rsispal/ILSS-DisabilityIN-Demo-2026/firmware/docs/STATE_MACHINE.md

# Link & indication state machine

How the lanyard and web twin move between link states, what the LEDs / actuators show, and which events drive each transition.

## Overview

```mermaid
stateDiagram-v2
  [*] --> Boot

  Boot --> Unpaired: power-up cue done
  note right of Boot
    LED: white + red star twinkle (~1.8s)
    Haptic: soft bumps (DRV #7)
    Buzzer: ascending beep-beep-BEEP (2–3.5 kHz)
    CLI wait: 2s (blue single flash)
  end note

  Unpaired --> Connecting: GATT connect
  note right of Unpaired
    LED: blue single flash / 3s @ 20%
    Ready / advertising
  end note

  Connecting --> PairedIdle: pair_ok
  Connecting --> Unpaired: disconnect / fail
  note right of Connecting
    LED: blue chase @ 30%
    Pairing in progress
  end note

  PairedIdle --> AlertFire: fire twin / web fire
  PairedIdle --> AlertPersonal: both-hold / personal twin
  PairedIdle --> Advanced: advanced twin (idle only)
  PairedIdle --> Unpaired: disconnect / HB fail
  note right of PairedIdle
    LED: green solid @ 10%
    After pair: brief green flash @ 100%
    Heartbeat every 10s
  end note

  AlertFire --> PairedIdle: clear / stand-down
  AlertFire --> Unpaired: disconnect / HB fail
  note right of AlertFire
    LED: red double-flash @ 100%
    Haptic: long-pulses (Alert 1000ms)
    Buzzer: code3-sweep
  end note

  AlertPersonal --> PairedIdle: clear / both-hold toggle
  AlertPersonal --> Unpaired: disconnect / HB fail
  note right of AlertPersonal
    LED: purple pulse @ 100%
    Haptic: long-pulses
    Buzzer: code3-siren
  end note

  Advanced --> PairedIdle: reset / idle twin
  Advanced --> Unpaired: disconnect / HB fail
  note right of Advanced
    LED/haptic/buzzer: commanded
    Web 30s autoreset
  end note
```

## Link states (device)

| State | How entered | LED indication | Other actuators | Exit events |
|---|---|---|---|---|
| **Boot** | Power-on / reset | White + red star twinkle (~1.8s); CLI wait blue single flash @ 20% | Soft haptic bumps + ascending beep-beep-BEEP (2–3.5 kHz) | Cue done → Unpaired |
| **Unpaired** | Boot done, disconnect, heartbeat fail | Blue `FLASH_SINGLE_3S` @ 20% | Off (stand-down clears alerts) | GATT connect → Connecting |
| **Connecting** | BLE GAP connect (not yet paired) | Blue chase @ 30% | Off | `pair_ok` → PairedIdle; disconnect → Unpaired |
| **PairedIdle** | Successful pair / alert clear | Green solid @ 10% (pair flash @ 100% first) | Off | Twin CMD, both-hold, disconnect, HB fail |
| **AlertFire** | Twin fire / web fire | Red double-flash @ 100% | Long-pulses haptic, code3-sweep buzzer | Clear → PairedIdle; disconnect/HB fail → Unpaired |
| **AlertPersonal** | Both-hold / twin personal | Purple pulse @ 100% | Long-pulses haptic, code3-siren | Clear / both-hold toggle → PairedIdle; disconnect/HB fail → Unpaired |
| **Advanced** | Twin with advanced flag while idle | Commanded LED pattern/color/brightness | Commanded haptic/buzzer | Idle twin / autoreset; disconnect/HB fail → Unpaired |

Stand-down on disconnect / heartbeat failure always: stop buzzer + haptics, clear alert to idle twin, set **Unpaired** blue flash, republish status.

## Heartbeat / poll

```mermaid
sequenceDiagram
  participant D as Lanyard
  participant W as Web twin

  Note over D,W: Paired session
  loop every 10s
    D->>W: EVT/CMD HEARTBEAT (0x02) + TwinState
    W->>W: Green LED pulse (UI only)
    W->>D: ACK HEARTBEAT (same msgId)
    alt no ACK within 4s
      D->>D: disconnect + Unpaired
      W->>W: link-lost modal (if silent)
    end
  end

  Note over W: If no device poll for ~12s
  W->>D: CMD HEARTBEAT
  alt RPL/ACK within 4s
    W->>W: Green LED pulse
  else timeout / write fail
    W->>W: Disconnect + "reset device" modal
  end
```

| Side | Interval | Timeout | On failure |
|---|---|---|---|
| **Device** | Poll every **10s** after pair | **4s** waiting for ACK | `ble_gap_terminate` → Unpaired (blue flash), clear indications |
| **Web** | Expect device poll; fallback poll after **~12s** silence | **4s** for reply | Disconnect GATT, show link-lost modal (“reset the lanyard”) |
| **Web UI** | On any successful heartbeat (device poll or web-poll reply) | — | Brief green LED pulse on virtual lanyard (no device LED change) |

## Other events

| Event | Source | Effect |
|---|---|---|
| Side button short press (L/R) | Device | EVT `0x10` button cue → web purple side-button flash (~280ms) |
| Both buttons hold | Device | Raise / clear personal alert + twin EVT |
| Twin state CMD | Web | Apply if mutual-exclusion / alert rules allow; ACK or NAK |
| Twin state EVT | Device | Web mirrors state (skip outbound echo) |
| Unpair (`0x03`) | Web | Clear session; device unpaired |

## Indication cheat-sheet

| Cue | Color | Pattern | When |
|-----|---|---|---|
| Ready | Blue | Single flash / 3s @ 20% | Unpaired / CLI wait |
| Pairing | Blue | Chase @ 30% | GATT connected, awaiting pair |
| Pair success | Green | Solid flash ~450ms @ 100% | `pair_ok` |
| Idle linked | Green | Solid @ 10% | Paired, no alert |
| Fire | Red | Double flash @ 100% | Fire alert |
| Personal | Purple | Pulse @ 100% | Personal alert |
| Web heartbeat | Green | Brief brightness pulse | UI only, on poll RX |

See also: [PACKET_PROTOCOL.md](PACKET_PROTOCOL.md), [PAIRING.md](PAIRING.md), [BLE_GATT.md](BLE_GATT.md).
