rsispal/ILSS-DisabilityIN-Demo-2026/frontend/uploads/honeywell-emboss.png

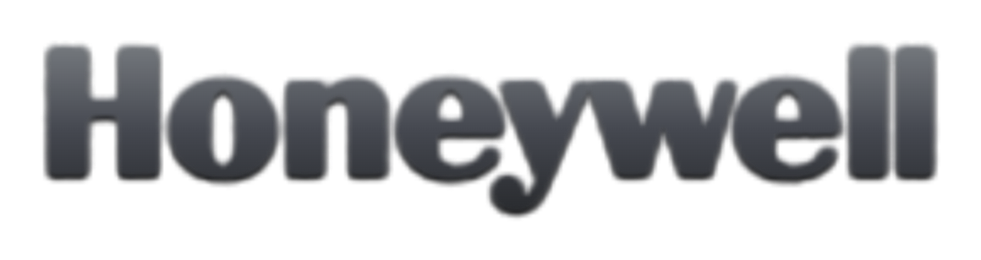
frontend/uploads/honeywell-emboss.png
