rsispal/ILSS-DisabilityIN-Demo-2026/pcb/ILSS_PCB_2026_DEMO/ILSS_LIBRARY/3D/UJ20-C-H-G-SMT-1-P16-TR.step

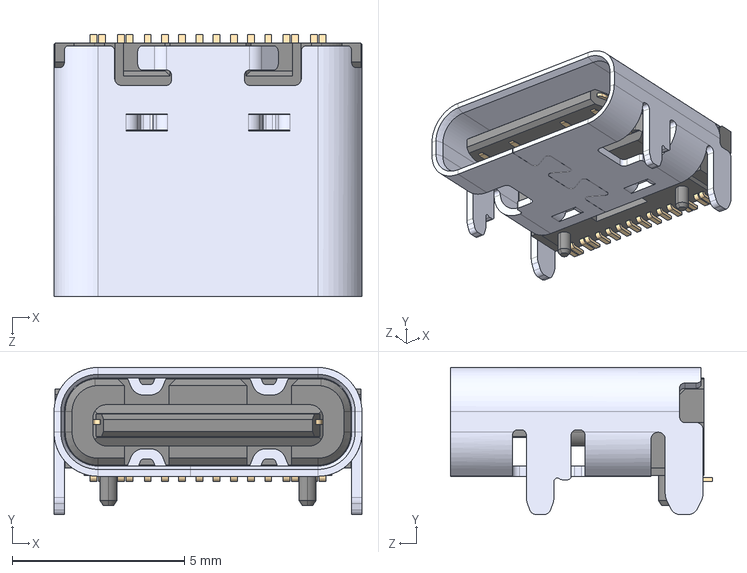
[picture p2: CAD file, 2026-07-12]
pcb/ILSS_PCB_2026_DEMO/ILSS_LIBRARY/3D/UJ20-C-H-G-SMT-1-P16-TR.step
8.94 x 4.27 x 7.60 mm
