rsispal/ILSS-DisabilityIN-Demo-2026/pcb/ILSS_PCB_2026_DEMO/ILSS_LIBRARY/3D/IN-S63BT.stp

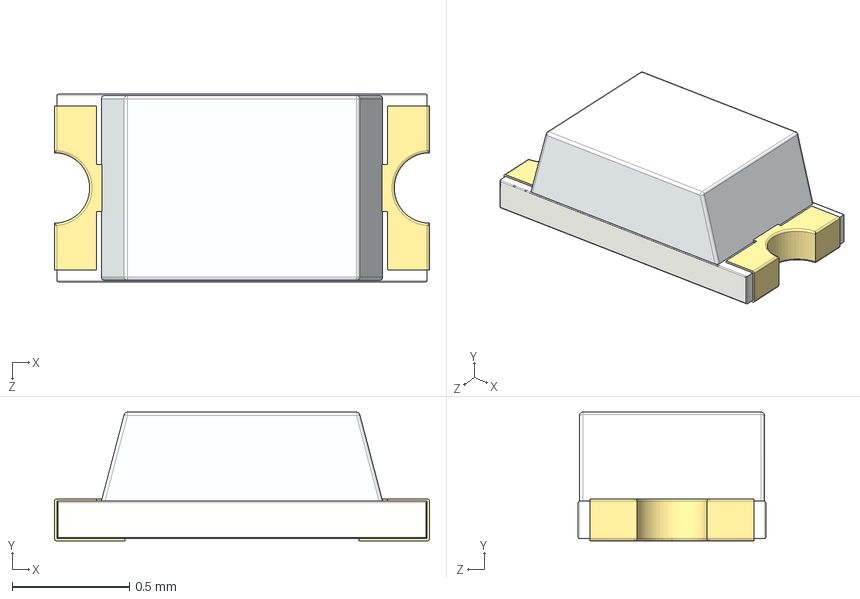
[picture p3: CAD file, 2026-07-12]
pcb/ILSS_PCB_2026_DEMO/ILSS_LIBRARY/3D/IN-S63BT.stp
1.60 x 0.55 x 0.8 mm
