rsispal/ILSS-DisabilityIN-Demo-2026/pcb/ILSS_PCB_2026_DEMO/ILSS_LIBRARY/3D/SLW-864574-5A-RA-N-D.step

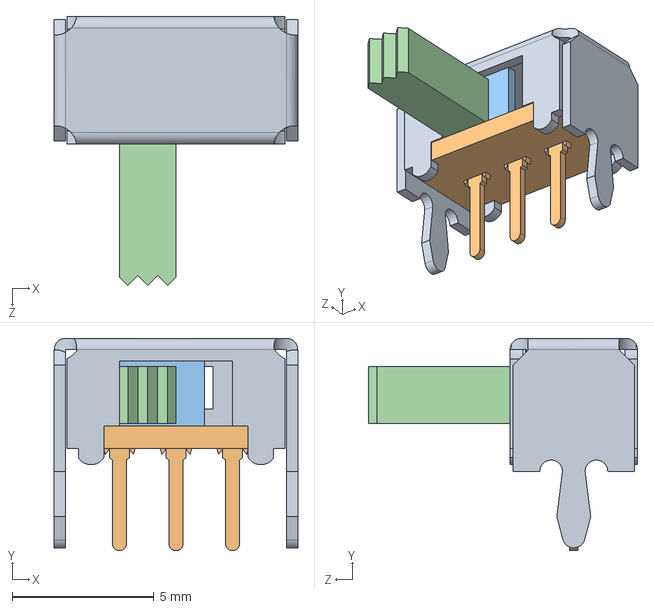
[picture p4: CAD file, 2026-07-12]
pcb/ILSS_PCB_2026_DEMO/ILSS_LIBRARY/3D/SLW-864574-5A-RA-N-D.step
8.60 x 7.50 x 9.50 mm
