rsispal/ILSS-DisabilityIN-Demo-2026/pcb/ILSS_PCB_2026_DEMO/ILSS_LIBRARY/3D/ADAFRUIT_SK6812_SIDE_4691.stp

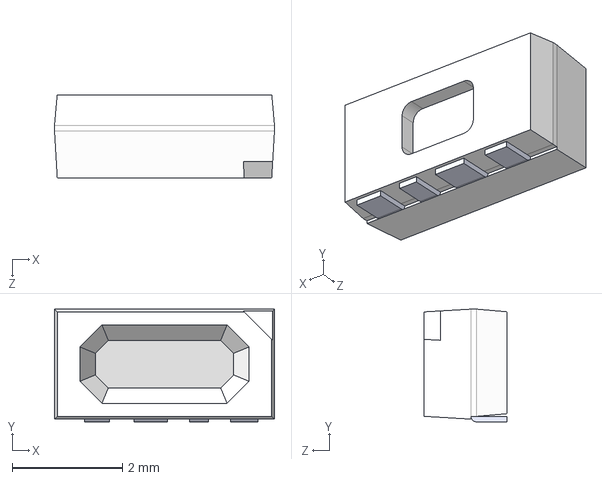
[picture p5: CAD file, 2026-07-12]
pcb/ILSS_PCB_2026_DEMO/ILSS_LIBRARY/3D/ADAFRUIT_SK6812_SIDE_4691.stp
4.00 x 2.05 x 1.50 mm
