rsispal/ILSS-DisabilityIN-Demo-2026/pcb/ILSS_PCB_2026_DEMO/ILSS_LIBRARY/3D/DRV2605LDGSR.stp

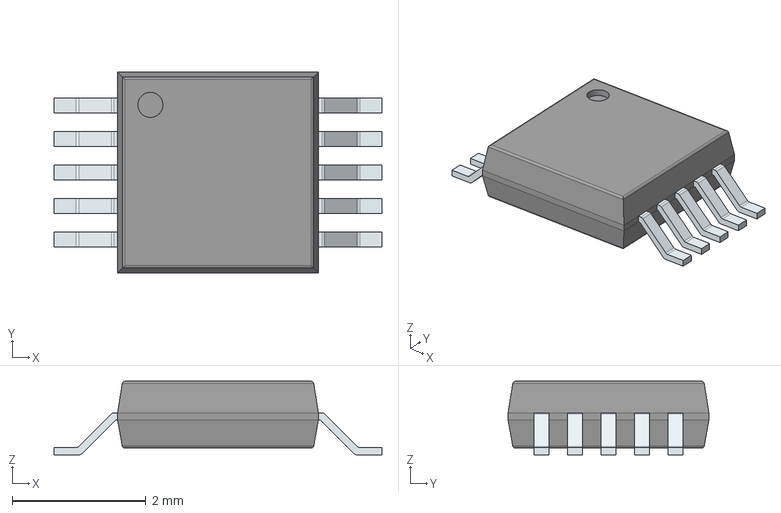
[picture p6: CAD file, 2026-07-12]
pcb/ILSS_PCB_2026_DEMO/ILSS_LIBRARY/3D/DRV2605LDGSR.stp
4.90 x 3.00 x 1.10 mm
PinsArrayLR
