rsispal/ILSS-DisabilityIN-Demo-2026/pcb/ILSS_PCB_2026_DEMO/ILSS_LIBRARY/3D/S2B-PH-SM4-TB.step

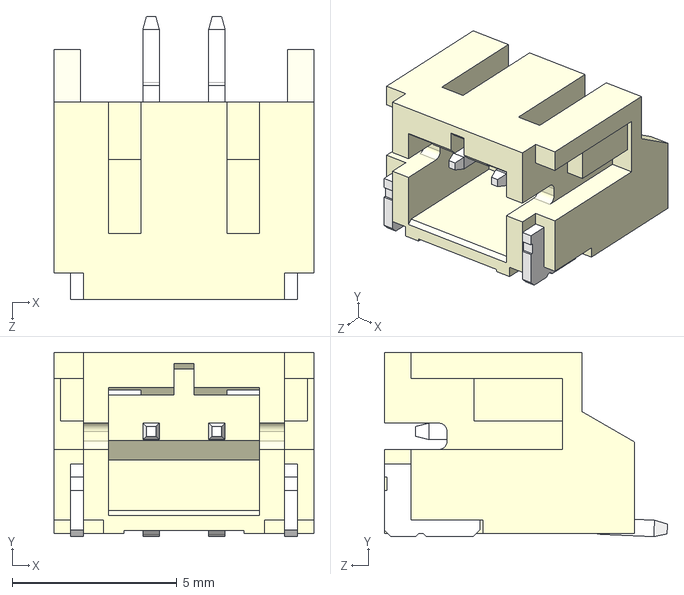
[picture p7: CAD file, 2026-07-12]
pcb/ILSS_PCB_2026_DEMO/ILSS_LIBRARY/3D/S2B-PH-SM4-TB.step
7.90 x 5.60 x 8.60 mm
