rsispal/ILSS-DisabilityIN-Demo-2026/pcb/ILSS_PCB_2026_DEMO/ILSS_LIBRARY/3D/TS11-674-50-BK-160-RA-D.step

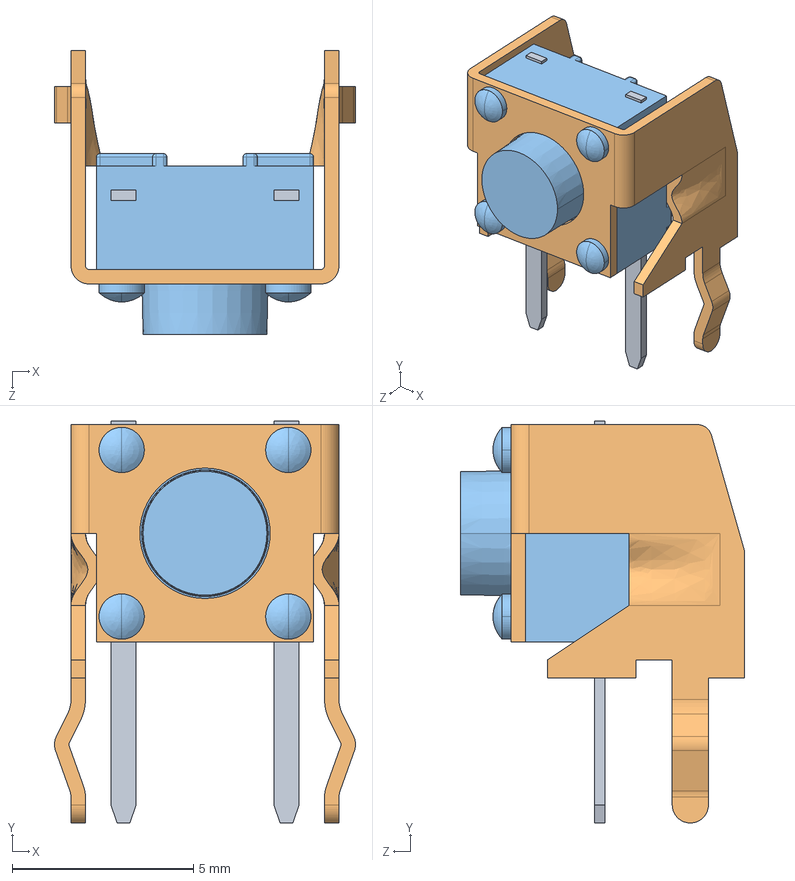
[picture p8: CAD file, 2026-07-12]
pcb/ILSS_PCB_2026_DEMO/ILSS_LIBRARY/3D/TS11-674-50-BK-160-RA-D.step
8.31 x 11.1 x 7.85 mm
