rsispal/ILSS-DisabilityIN-Demo-2026/pcb/ILSS_PCB_2026_DEMO/ILSS_LIBRARY/3D/CMT-7525-03-SMT-TR.stp

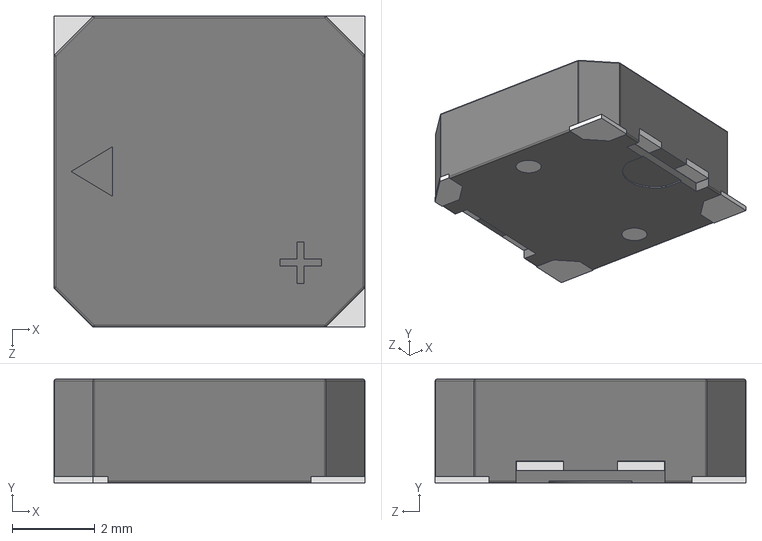
[picture p9: CAD file, 2026-07-12]
pcb/ILSS_PCB_2026_DEMO/ILSS_LIBRARY/3D/CMT-7525-03-SMT-TR.stp
7.50 x 2.50 x 7.50 mm
