rsispal/ILSS-DisabilityIN-Demo-2026/pcb/ILSS_PCB_2026_DEMO/ILSS_LIBRARY/3D/MAX17048G_T10.step

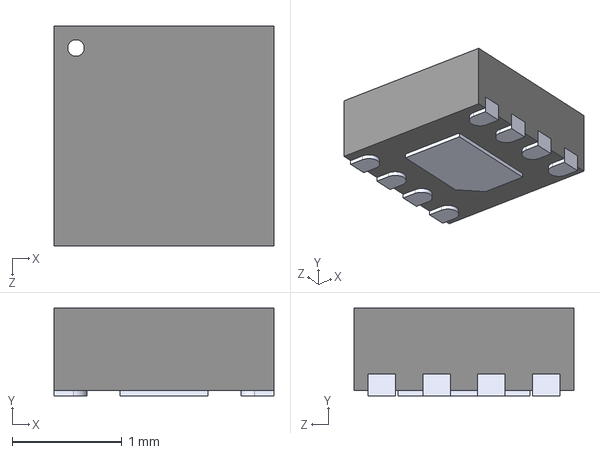
[picture p10: CAD file, 2026-07-12]
pcb/ILSS_PCB_2026_DEMO/ILSS_LIBRARY/3D/MAX17048G_T10.step
2.00 x 0.8 x 2.00 mm
