rsispal/ILSS-DisabilityIN-Demo-2026/pcb/ILSS_PCB_2026_DEMO/ILSS_PCB_2026_DEMO.kicad_pcb

## KiCad design pcb/ILSS_PCB_2026_DEMO/ILSS_PCB_2026_DEMO.kicad_pcb (2026-07-13)

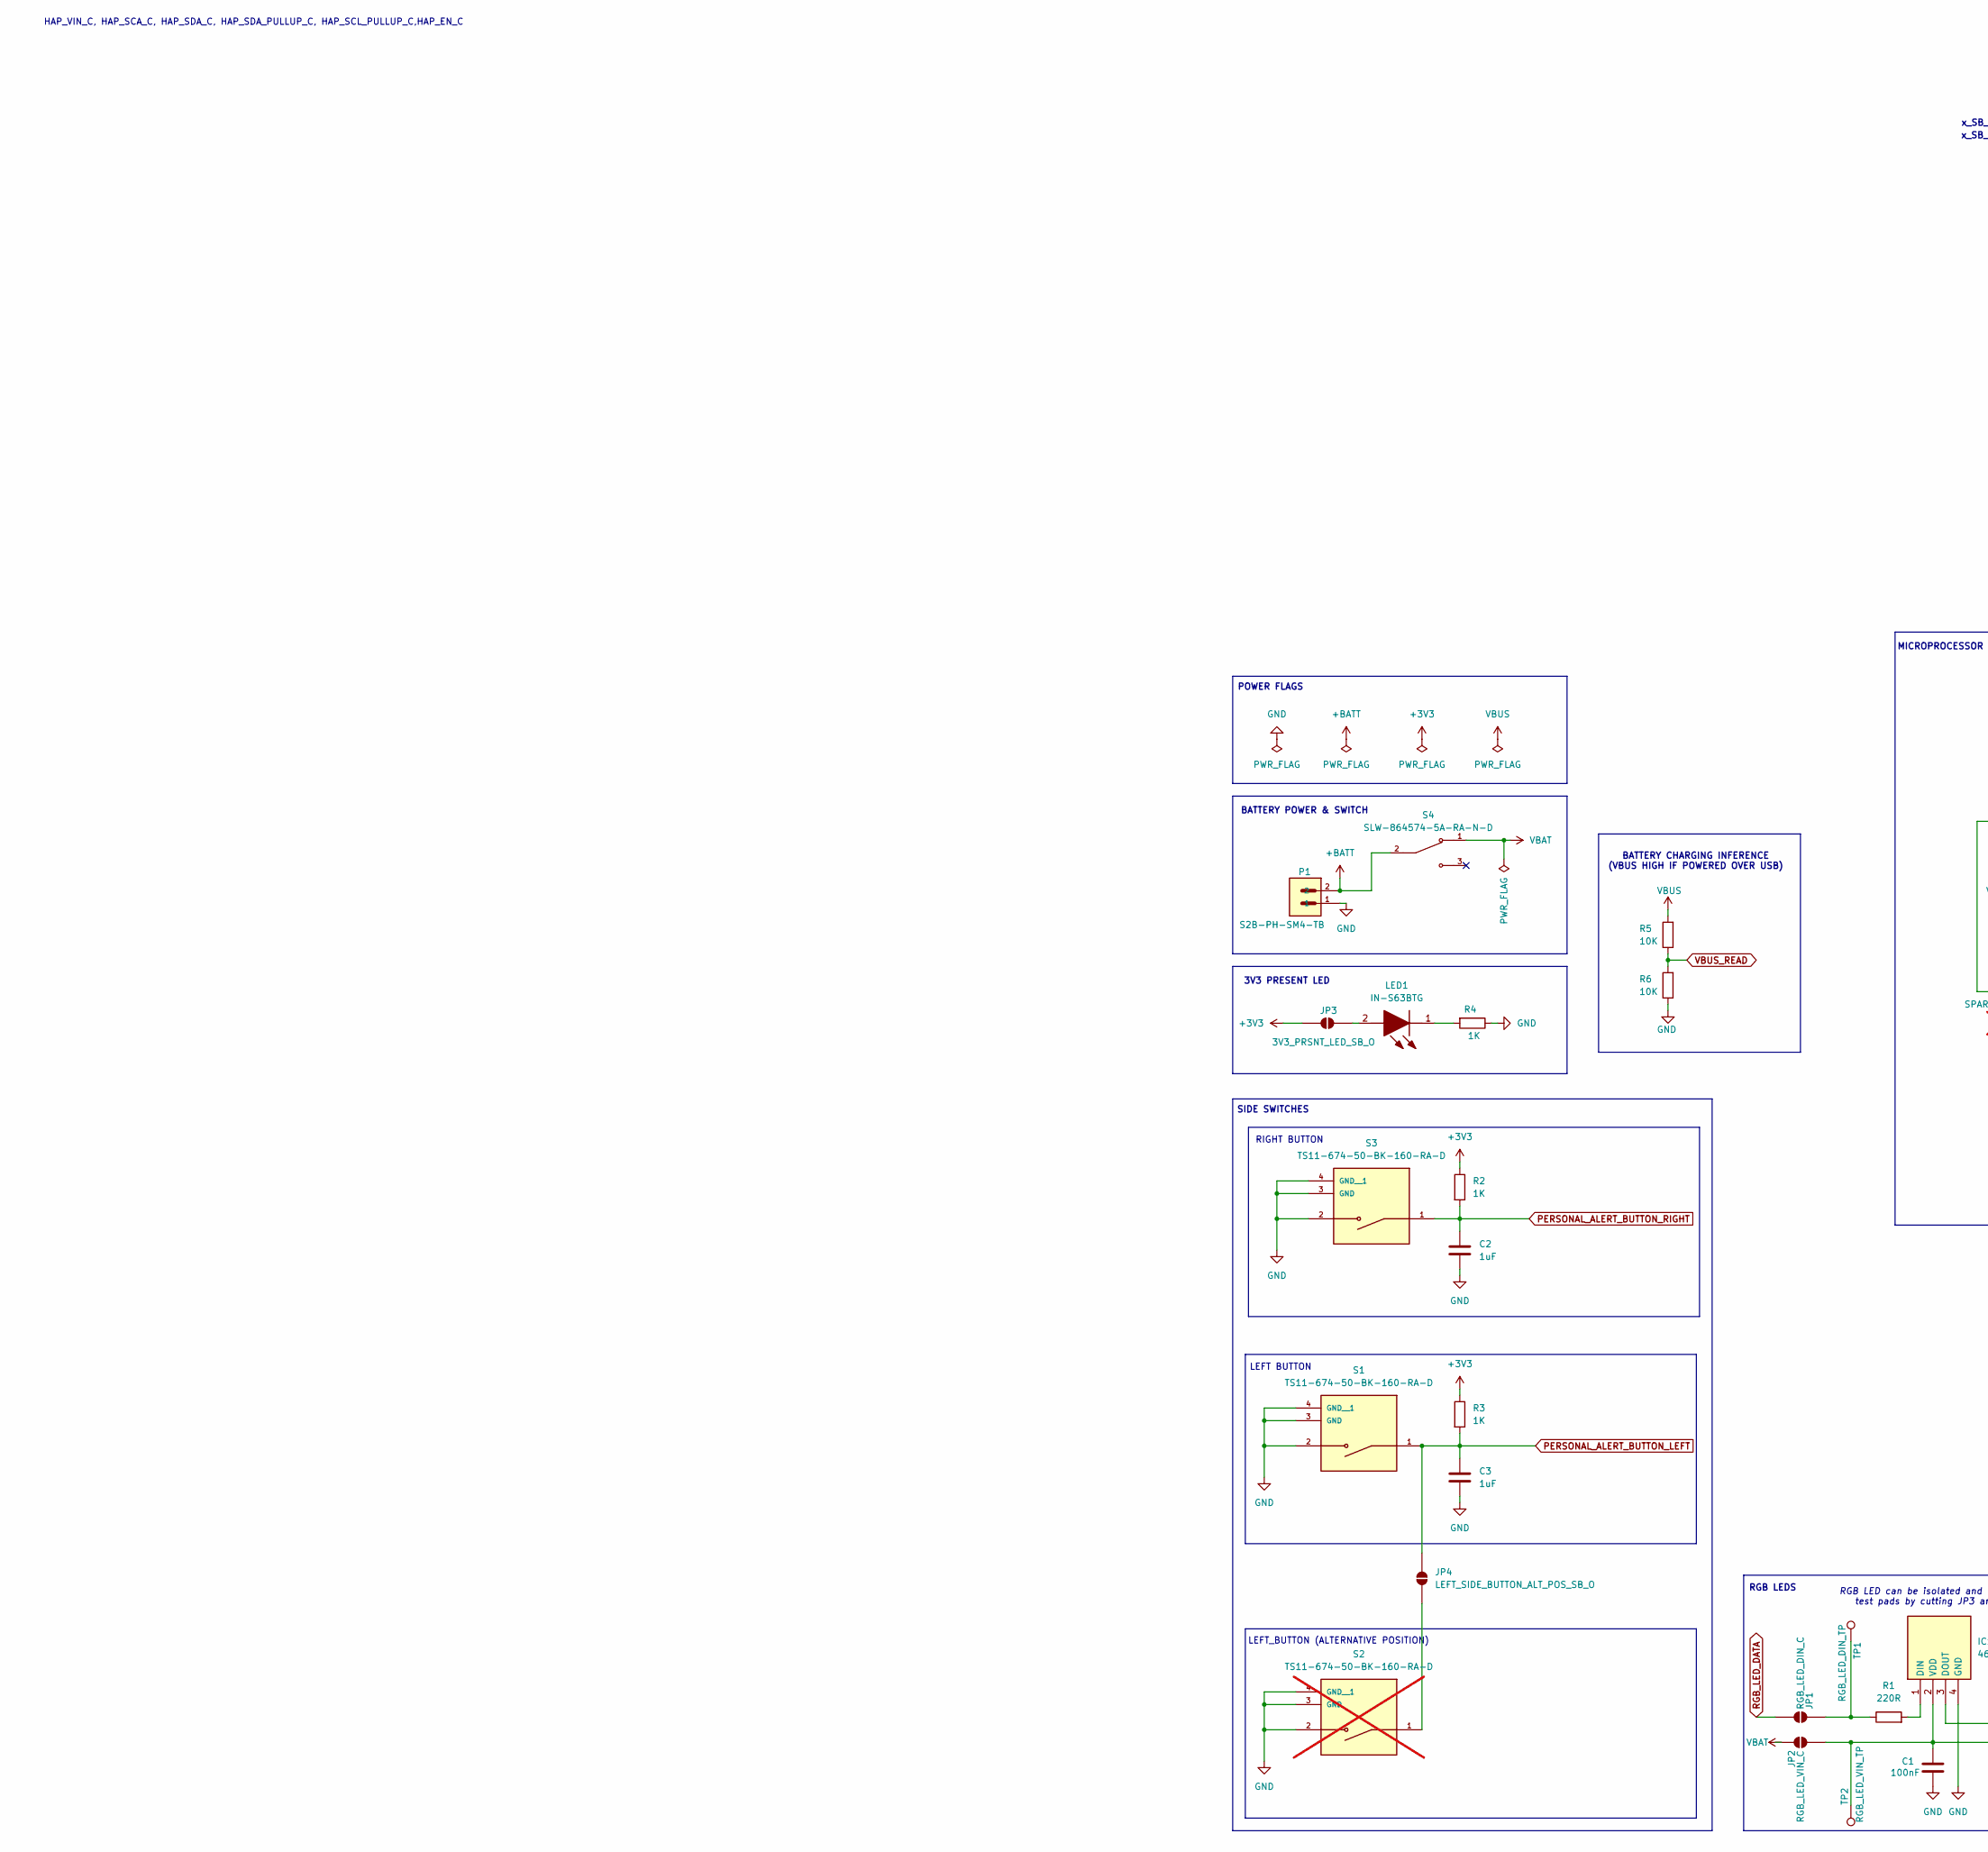
[picture p11: schematic ILSS_PCB_2026_DEMO.kicad_sch, ILSS LANYARD PROTOTYPE (DISABILITY:IN 2026), part in row 1, column 1]

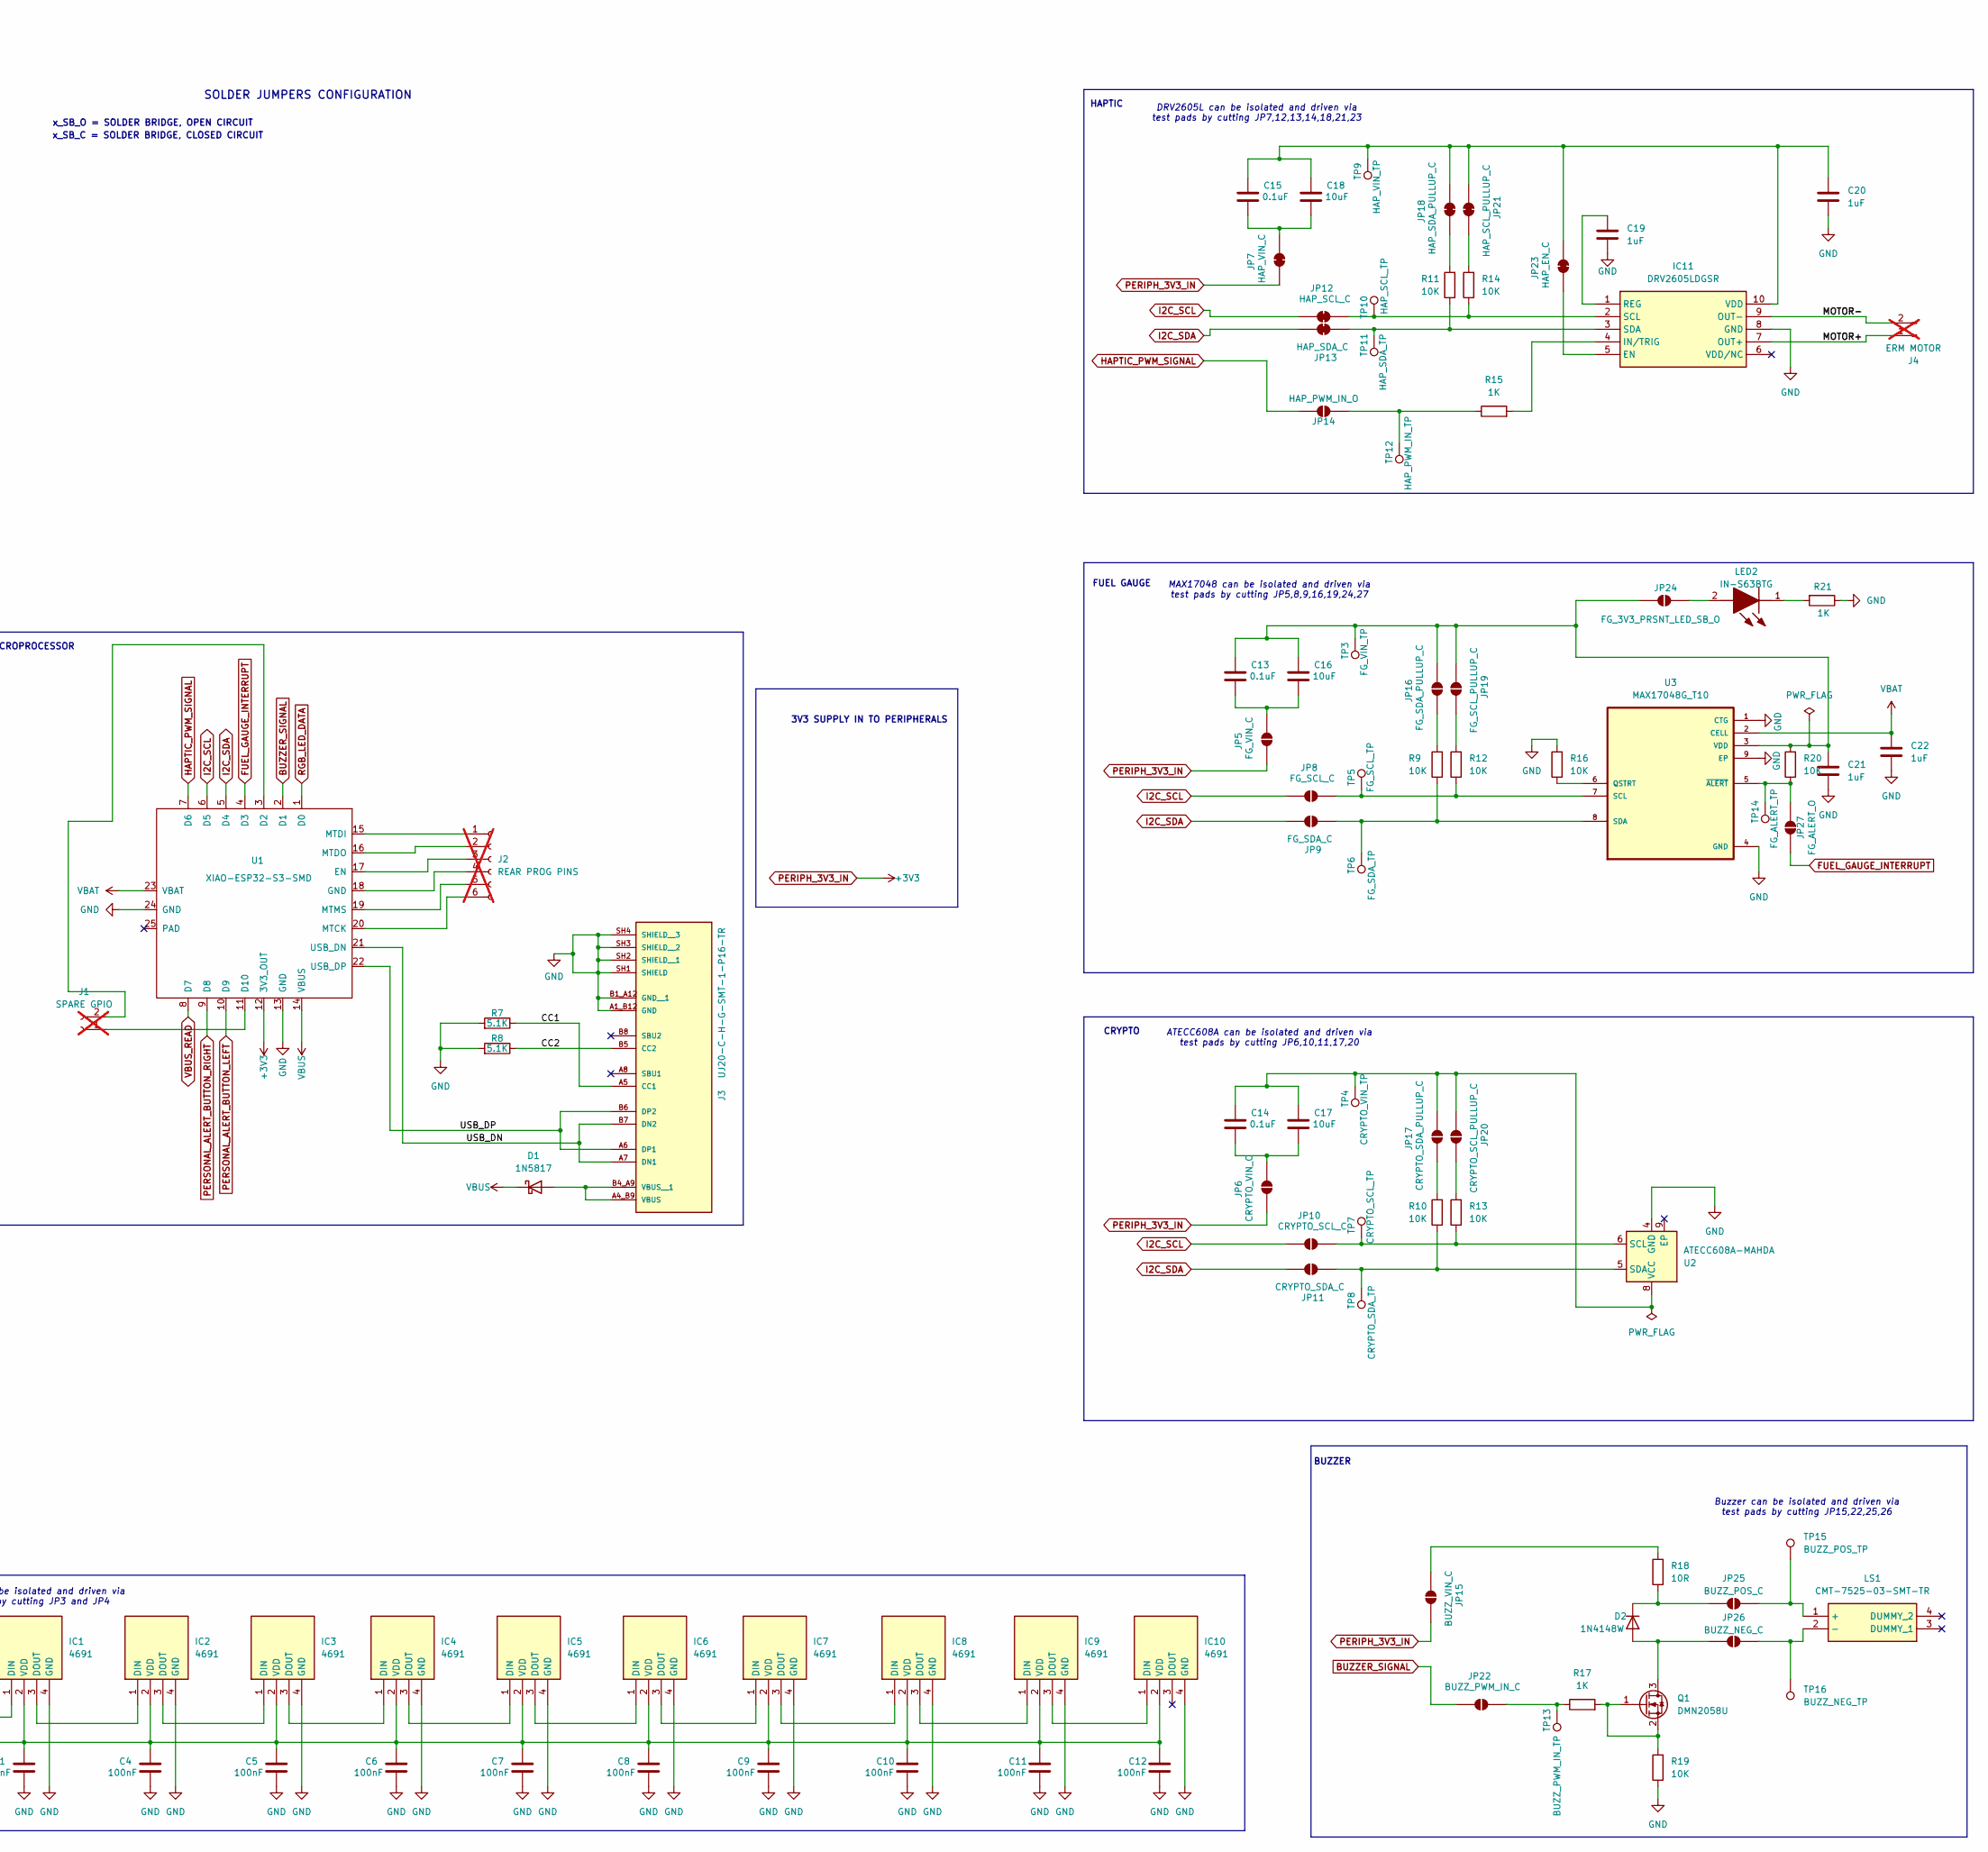
[picture p12: schematic ILSS_PCB_2026_DEMO.kicad_sch, ILSS LANYARD PROTOTYPE (DISABILITY:IN 2026), part in row 1, column 2]

Parts:
C1, C4, C5, C6, C7, C8, C9, C10, C11, C12: 100nF; C_0603_1608Metric_Pad1.08x0.95mm_HandSolder
C2, C3, C19, C20, C21, C22: 1uF; C_0603_1608Metric_Pad1.08x0.95mm_HandSolder
C13, C14, C15: 0.1uF; C_0603_1608Metric_Pad1.08x0.95mm_HandSolder
C16, C17, C18: 10uF; C_0603_1608Metric_Pad1.08x0.95mm_HandSolder
D1: 1N5817; D_SOD-123
D2: 1N4148W; D_SOD-123
IC1, IC2, IC3, IC4, IC5, IC6, IC7, IC8, IC9, IC10: 4691; ADAFRUIT_SK6812_SIDE_4691; Mouser Part Number 485-4691
IC11: DRV2605LDGSR; SOP50P490X110-10N; Mouser Part Number 595-DRV2605LDGSR
J1: SPARE GPIO; PinHeader_1x02_P2.54mm_Vertical; not fitted
J2: REAR PROG PINS; PinHeader_1x06_P2.54mm_Vertical; not fitted
J3: UJ20-C-H-G-SMT-1-P16-TR; SAMESKY_UJ20-C-H-G-SMT-1-P16-TR; PARTREV 1.0
J4: ERM MOTOR; PinHeader_1x02_P2.54mm_Vertical; not fitted
JP1: RGB_LED_DIN_C; SolderJumper-2_P1.3mm_Open_Pad1.0x1.5mm
JP2: RGB_LED_VIN_C; SolderJumper-2_P1.3mm_Open_Pad1.0x1.5mm
JP3: 3V3_PRSNT_LED_SB_O; SolderJumper-2_P1.3mm_Open_Pad1.0x1.5mm
JP4: LEFT_SIDE_BUTTON_ALT_POS_SB_O; SolderJumper-2_P1.3mm_Open_Pad1.0x1.5mm
JP5: FG_VIN_C; SolderJumper-2_P1.3mm_Open_Pad1.0x1.5mm
JP6: CRYPTO_VIN_C; SolderJumper-2_P1.3mm_Open_Pad1.0x1.5mm
JP7: HAP_VIN_C; SolderJumper-2_P1.3mm_Open_Pad1.0x1.5mm
JP8: FG_SCL_C; SolderJumper-2_P1.3mm_Open_Pad1.0x1.5mm
JP9: FG_SDA_C; SolderJumper-2_P1.3mm_Open_Pad1.0x1.5mm
JP10: CRYPTO_SCL_C; SolderJumper-2_P1.3mm_Open_Pad1.0x1.5mm
JP11: CRYPTO_SDA_C; SolderJumper-2_P1.3mm_Open_Pad1.0x1.5mm
JP12: HAP_SCL_C; SolderJumper-2_P1.3mm_Open_Pad1.0x1.5mm
JP13: HAP_SDA_C; SolderJumper-2_P1.3mm_Open_Pad1.0x1.5mm
JP14: HAP_PWM_IN_O; SolderJumper-2_P1.3mm_Open_Pad1.0x1.5mm
JP15: BUZZ_VIN_C; SolderJumper-2_P1.3mm_Open_Pad1.0x1.5mm
JP16: FG_SDA_PULLUP_C; SolderJumper-2_P1.3mm_Open_Pad1.0x1.5mm
JP17: CRYPTO_SDA_PULLUP_C; SolderJumper-2_P1.3mm_Open_Pad1.0x1.5mm
JP18: HAP_SDA_PULLUP_C; SolderJumper-2_P1.3mm_Open_Pad1.0x1.5mm
JP19: FG_SCL_PULLUP_C; SolderJumper-2_P1.3mm_Open_Pad1.0x1.5mm
JP20: CRYPTO_SCL_PULLUP_C; SolderJumper-2_P1.3mm_Open_Pad1.0x1.5mm
JP21: HAP_SCL_PULLUP_C; SolderJumper-2_P1.3mm_Open_Pad1.0x1.5mm
JP22: BUZZ_PWM_IN_C; SolderJumper-2_P1.3mm_Open_Pad1.0x1.5mm
JP23: HAP_EN_C; SolderJumper-2_P1.3mm_Open_Pad1.0x1.5mm
JP24: FG_3V3_PRSNT_LED_SB_O; SolderJumper-2_P1.3mm_Open_Pad1.0x1.5mm
JP25: BUZZ_POS_C; SolderJumper-2_P1.3mm_Open_Pad1.0x1.5mm
JP26: BUZZ_NEG_C; SolderJumper-2_P1.3mm_Open_Pad1.0x1.5mm
JP27: FG_ALERT_O; SolderJumper-2_P1.3mm_Open_Pad1.0x1.5mm
LED1, LED2: IN-S63BTG; LEDC1608X55N; Mouser Part Number 743-IN-S63BTG
LS1: CMT-7525-03-SMT-TR; CMT752503SMTTR; Mouser Part Number 179-CMT-7525-03SMTTR
P1: S2B-PH-SM4-TB; JST_S2B-PH-SM4-TB
Q1: DMN2058U; SOT-23
R1: 220R; R_0603_1608Metric_Pad0.98x0.95mm_HandSolder
R2, R3, R4, R15, R17, R21: 1K; R_0603_1608Metric_Pad0.98x0.95mm_HandSolder
R5, R6, R9, R10, R11, R12, R13, R14, R16, R19, R20: 10K; R_0603_1608Metric_Pad0.98x0.95mm_HandSolder
R7, R8: 5.1K; R_0603_1608Metric_Pad0.98x0.95mm_HandSolder
R18: 10R; R_0603_1608Metric_Pad0.98x0.95mm_HandSolder
S1, S3: TS11-674-50-BK-160-RA-D; SW_TS11-674-50-BK-160-RA-D; PARTREV 1.01
S2: TS11-674-50-BK-160-RA-D; SW_TS11-674-50-BK-160-RA-D; PARTREV 1.01; not fitted
S4: SLW-864574-5A-RA-N-D; SW_SLW-864574-5A-RA-N-D; PARTREV 1.01
TP1: RGB_LED_DIN_TP; TestPoint_Pad_D2.0mm
TP2: RGB_LED_VIN_TP; TestPoint_Pad_D2.0mm
TP3: FG_VIN_TP; TestPoint_Pad_D2.0mm
TP4: CRYPTO_VIN_TP; TestPoint_Pad_D2.0mm
TP5: FG_SCL_TP; TestPoint_Pad_D2.0mm
TP6: FG_SDA_TP; TestPoint_Pad_D2.0mm
TP7: CRYPTO_SCL_TP; TestPoint_Pad_D2.0mm
TP8: CRYPTO_SDA_TP; TestPoint_Pad_D2.0mm
TP9: HAP_VIN_TP; TestPoint_Pad_D2.0mm
TP10: HAP_SCL_TP; TestPoint_Pad_D2.0mm
TP11: HAP_SDA_TP; TestPoint_Pad_D2.0mm
TP12: HAP_PWM_IN_TP; TestPoint_Pad_D2.0mm
TP13: BUZZ_PWM_IN_TP; TestPoint_Pad_D2.0mm
TP14: FG_ALERT_TP; TestPoint_Pad_D2.0mm
TP15: BUZZ_POS_TP; TestPoint_Pad_D2.0mm
TP16: BUZZ_NEG_TP; TestPoint_Pad_D2.0mm
U1: XIAO-ESP32-S3-SMD
U2: ATECC608A-MAHDA; DFN-8-1EP_3x2mm_P0.5mm_EP1.3x1.5mm
U3: MAX17048G_T10; SON50P200X200X80-9N

Connections:
+BATT: P1.2, S4.2
/CC1: J3.A5 (CC1), R7.1
/CC2: J3.B5 (CC2), R8.1
/MOTOR+: IC11.7 (OUT+), J4.1
/MOTOR-: IC11.9 (OUT-), J4.2
/USB_DN: J3.A7 (DN1), J3.B7 (DN2), U1.21 (USB_DN)
/USB_DP: J3.A6 (DP1), J3.B6 (DP2), U1.22 (USB_DP)
BUZZER_SIGNAL: JP22.2 (B), U1.2 (D1)
FUEL_GAUGE_INTERRUPT: JP27.1 (A), U1.4 (D3)
GND: C1.2, C2.2, C3.2, C4.2, C5.2, C6.2, C7.2, C8.2, C9.2, C10.2, C11.2, C12.2, C19.2, C20.1, C21.1, C22.1, IC1.4 (GND), IC2.4 (GND), IC3.4 (GND), IC4.4 (GND), IC5.4 (GND), IC6.4 (GND), IC7.4 (GND), IC8.4 (GND), IC9.4 (GND), IC10.4 (GND), IC11.8 (GND), J3.A1_B12 (GND), J3.B1_A12 (GND__1), J3.SH1 (SHIELD), J3.SH2 (SHIELD__1), J3.SH3 (SHIELD__2), J3.SH4 (SHIELD__3), P1.1, R4.1, R6.1, R7.2, R8.2, R16.2, R19.1, R21.1, S1.2, S1.3 (GND), S1.4 (GND__1), S2.2, S2.3 (GND), S2.4 (GND__1), S3.2, S3.3 (GND), S3.4 (GND__1), U1.13 (GND), U1.24 (GND), U2.4 (GND), U3.1 (CTG), U3.4 (GND), U3.9 (EP)
HAPTIC_PWM_SIGNAL: JP14.2 (B), U1.7 (D6)
I2C_SCL: JP8.2 (B), JP10.2 (B), JP12.2 (B), U1.6 (D5)
I2C_SDA: JP9.1 (A), JP11.1 (A), JP13.1 (A), U1.5 (D4)
unnamed: D1.2 (A), J3.A4_B9 (VBUS), J3.B4_A9 (VBUS__1)
unnamed: D2.2 (A), JP26.1 (A), Q1.3 (D)
unnamed: D2.1 (K), JP25.1 (A), R18.1
unnamed: IC1.1 (DIN), R1.2
unnamed: IC1.3 (DOUT), IC2.1 (DIN)
unnamed: C1.1, C4.1, C5.1, C6.1, C7.1, C8.1, C9.1, C10.1, C11.1, C12.1, IC1.2 (VDD), IC2.2 (VDD), IC3.2 (VDD), IC4.2 (VDD), IC5.2 (VDD), IC6.2 (VDD), IC7.2 (VDD), IC8.2 (VDD), IC9.2 (VDD), IC10.2 (VDD), JP2.2 (B), TP2.1 (1_1)
unnamed: IC2.3 (DOUT), IC3.1 (DIN)
unnamed: IC3.3 (DOUT), IC4.1 (DIN)
unnamed: IC4.3 (DOUT), IC5.1 (DIN)
unnamed: IC5.3 (DOUT), IC6.1 (DIN)
unnamed: IC6.3 (DOUT), IC7.1 (DIN)
unnamed: IC7.3 (DOUT), IC8.1 (DIN)
unnamed: IC8.3 (DOUT), IC9.1 (DIN)
unnamed: IC9.3 (DOUT), IC10.1 (DIN)
unnamed: IC11.5 (EN), JP23.2 (B)
unnamed: IC11.4 (IN/TRIG), R15.2
unnamed: C19.1, IC11.1 (REG)
unnamed: IC11.2 (SCL), JP12.1 (A), R14.1, TP10.1 (1_1)
unnamed: IC11.3 (SDA), JP13.2 (B), R11.1, TP11.1 (1_1)
unnamed: C15.1, C18.1, C20.2, IC11.10 (VDD), JP18.1 (A), JP21.2 (B), JP23.1 (A), TP9.1 (1_1)
unnamed: J1.1, U1.11 (D10)
unnamed: J1.2, U1.3 (D2)
unnamed: J2.1, U1.15 (MTDI)
unnamed: J2.2, U1.16 (MTDO)
unnamed: J2.3, U1.17 (EN)
unnamed: J2.4, U1.18 (GND)
unnamed: J2.5, U1.19 (MTMS)
unnamed: J2.6, U1.20 (MTCK)
unnamed: JP1.1 (A), R1.1, TP1.1 (1_1)
unnamed: JP3.2 (B), LED1.2 (A)
unnamed: JP4.1 (A), S2.1
unnamed: C13.2, C16.2, JP5.1 (A)
unnamed: C14.2, C17.2, JP6.1 (A)
unnamed: C15.2, C18.2, JP7.1 (A)
unnamed: JP8.1 (A), R12.1, TP5.1 (1_1), U3.7 (SCL)
unnamed: JP9.2 (B), R9.1, TP6.1 (1_1), U3.8 (SDA)
unnamed: JP10.1 (A), R13.1, TP7.1 (1_1), U2.6 (SCL)
unnamed: JP11.2 (B), R10.1, TP8.1 (1_1), U2.5 (SDA)
unnamed: JP14.1 (A), R15.1, TP12.1 (1_1)
unnamed: JP15.2 (B), R18.2
unnamed: C13.1, C16.1, C21.2, JP16.1 (A), JP19.2 (B), JP24.1 (A), R20.2, TP3.1 (1_1), U3.3 (VDD)
unnamed: JP16.2 (B), R9.2
unnamed: C14.1, C17.1, JP17.1 (A), JP20.2 (B), TP4.1 (1_1), U2.8 (VCC)
unnamed: JP17.2 (B), R10.2
unnamed: JP18.2 (B), R11.2
unnamed: JP19.1 (A), R12.2
unnamed: JP20.1 (A), R13.2
unnamed: JP21.1 (A), R14.2
unnamed: JP22.1 (A), R17.1, TP13.1 (1_1)
unnamed: JP24.2 (B), LED2.2 (A)
unnamed: JP25.2 (B), LS1.1 (+), TP15.1 (1_1)
unnamed: JP26.2 (B), LS1.2 (-), TP16.1 (1_1)
unnamed: JP27.2 (B), R20.1, TP14.1 (1_1), U3.5 (~ALERT)
unnamed: LED1.1 (K), R4.2
unnamed: LED2.1 (K), R21.2
unnamed: Q1.1 (G), Q1.2 (S), R17.2, R19.2
unnamed: R16.1, U3.6 (QSTRT)
PERIPH_3V3_IN: JP3.1 (A), JP5.2 (B), JP6.2 (B), JP7.2 (B), JP15.1 (A), R2.1, R3.1, U1.12 (3V3_OUT)
PERSONAL_ALERT_BUTTON_LEFT: C3.1, JP4.2 (B), R3.2, S1.1, U1.10 (D9)
PERSONAL_ALERT_BUTTON_RIGHT: C2.1, R2.2, S3.1, U1.9 (D8)
RGB_LED_DATA: JP1.2 (B), U1.1 (D0)
VBAT: C22.2, JP2.1 (A), S4.1, U1.23 (VBAT), U3.2 (CELL)
VBUS: D1.1 (K), R5.2, U1.14 (VBUS)
VBUS_READ: R5.1, R6.2, U1.8 (D7)

Notes on the sheet:
ATECC608A can be isolated and driven via test pads by cutting JP6,10,11,17,20
3V3 SUPPLY IN TO PERIPHERALS
RGB LED can be isolated and driven via test pads by cutting JP3 and JP4
BATTERY CHARGING INFERENCE (VBUS HIGH IF POWERED OVER USB)
FUEL GAUGE
BUZZER
BATTERY POWER & SWITCH
HAPTIC
HAP_VIN_C, HAP_SCA_C, HAP_SDA_C, HAP_SDA_PULLUP_C, HAP_SCL_PULLUP_C,HAP_EN_C
DRV2605L can be isolated and driven via test pads by cutting JP7,12,13,14,18,21,23
LEFT_BUTTON (ALTERNATIVE POSITION)
SIDE SWITCHES
RIGHT BUTTON
Buzzer can be isolated and driven via test pads by cutting JP15,22,25,26
x_SB_C = SOLDER BRIDGE, CLOSED CIRCUIT
MAX17048 can be isolated and driven via test pads by cutting JP5,8,9,16,19,24,27
3V3 PRESENT LED
RGB LEDS
MICROPROCESSOR
CRYPTO
LEFT BUTTON
SOLDER JUMPERS CONFIGURATION
x_SB_O = SOLDER BRIDGE, OPEN CIRCUIT
POWER FLAGS

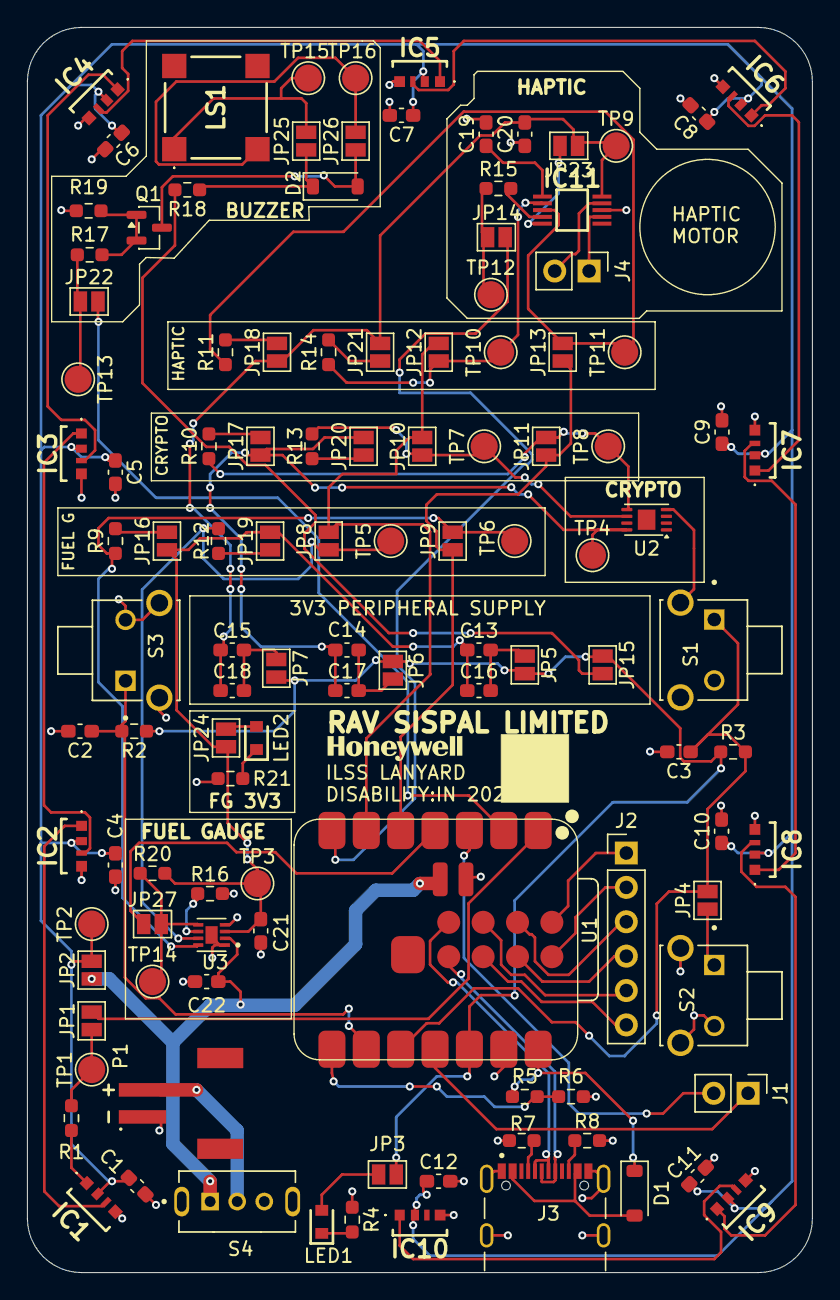
[picture p13: board ILSS_PCB_2026_DEMO.kicad_pcb from above]

Board: 2 copper layers, 58.0 x 92.0 mm, 115 parts (0 on the bottom side), 77 nets.
