rsispal/ILSS-DisabilityIN-Demo-2026/(commit log)

2026-07-08 Migrate ILSS Lanyard Simulator to React/TypeScript/Vite
    Port the vanilla UMD prototype into a componentized Vite app while
    preserving the full simulator experience: 3D lanyard visuals, alert
    presets, advanced LED/haptic/buzzer controls, Web Audio synthesis,
    BLE pairing UI, and experiments modal.
    - Add Vite + TypeScript toolchain with React Router
    - Componentize layout, controls, lanyard, BLE, and experiments
    - Extract hooks for simulator state, feature flags, and audio output
    - Split CSS into modular stylesheets; move DS bundle to public/_ds
    - Remove legacy app.js, lanyard.js, audio.js, ble.js, and styles.css
2026-07-08 Improve mobile UX with bottom sheet controls and device vibration
    - Add MobileControlsSheet: fire/personal presets, conditional clear actions,
    expandable advanced LED/haptic/buzzer panels
    - Scale lanyard to fit viewport above the sheet on mobile
    - Mirror haptic patterns via Web Vibration API on supported devices
    - Hide desktop side panels on mobile; reposition Experiments FAB
2026-07-08 Fix mobile bottom sheet interaction and remove device vibration
    - Remove Web Vibration API haptics (annoying on real devices)
    - Rebuild bottom sheet with drag handle, snap points (collapsed/open/expanded),
    backdrop dismiss, and swipe-up hint
    - Stack fire and personal alert buttons full-width
    - Move Experiments into advanced section; hide floating FAB on mobile
2026-07-08 Group alert reset buttons and redesign mobile alert banner
    - Pair each clear/reset button directly under its alert trigger (fire, then personal)
    - Disable cross-alert triggers while the other event is active
    - Redesign alert banner as stacked rows on mobile with updated copy
    - Remove CODE RED; show Assist! badge for personal alerts only
2026-07-08 Add custom menu bar with Honeywell logo and avatar Bluetooth menu
    Replace the Forge DS Header with a custom AppMenuBar that mirrors the
    standard Forge header layout (menu toggle, fixed bar, spacer, gradient).
    - Use official Honeywell wordmark via DS Logo (icon=false)
    - Integrate Bluetooth pairing into UserAvatarMenu dropdown
    - Show BLE connection status as a dot on the user avatar
    - Extract shared BLE logic into useBleConnect hook
2026-07-08 Use official Honeywell logo, remove hamburger, add sheet close button
    - Replace Forge wordmark with provided official Honeywell SVG
    - Remove navigation hamburger from AppMenuBar
    - Add centered circular close button on mobile bottom sheet
2026-07-08 Move bottom sheet close button to top-right inside sheet (iOS modal style)
2026-07-08 Apply iOS dark material blur to mobile bottom sheet and backdrop
2026-07-08 Revert backdrop blur; keep iOS material blur on sheet panel only
2026-07-08 Fix avatar Bluetooth menu overlap on mobile header
    The avatar trigger (42px) overflowed the 48px mobile header, and the
    header gradient pseudo-element painted over the bottom of the pill and
    BLE status dot.
    - Increase mobile header min-height and reduce vertical padding so the
    trigger fits without clipping
    - Raise app-menu-bar-right above the header gradient with z-index
    - Shrink the BLE dot to 8px border-box and tighten corner placement
    - Sync mobile spacer height and expose --mobile-header for sheet layout
2026-07-08 Mobile: collapsed sheet on load with lanyard intro animation (#4)
    * Start mobile with collapsed sheet and lanyard intro animation
    - Bottom sheet now loads in dismissed (collapsed) state so the lanyard
    fills the viewport above the peek bar.
    - On mobile first load, the green LED ring stays hidden for 1s then fades
    on while two audio pulse rings play twice to draw attention.
    * Show LED in off state on load, then fade to green
    Use data-pat="off" during the intro wait phase so the recessed LED
    channel renders without glow, then switch to solid green with a fade-in
    animation after one second.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
2026-07-09 Copy ILSS phase 3 lanyard firmware source
    [partitions.csv]
2026-07-09 Implement BLE digital twin sync between firmware and web simulator
    Strip Azure/Wi-Fi/beacon/USB provisioning from the ported firmware and replace
    the main app with an event-driven DigitalTwinApplication. Add NimBLE GATT
    metadata/control/log services, a packed TwinState packet protocol, indication
    timing parity with the web UI, factory ble_prov provisioning, and a React
    BleTwinContext with secret device-logs sidebar.
    [partitions.csv]
2026-07-09 Replace Python provisioner with Go CLI and clear docs
    Remove provision_lanyard.py in favor of tools/provision-lanyard (Go) and a
    bash wrapper. Add docs/PROVISIONING.md covering when to run ble_prov
    programming versus normal app flashes.
    [partitions.csv]
2026-07-10 Harden BLE twin link liveness and polish lanyard indications.
    Add heartbeat poll/ACK with disconnect failsafe, remapped DRV haptics, reliable buzzer stop, Honeywell white/red power-up cue, and document the full link/indication state machine.
    [BluetoothLowLevelDriver.cpp, BluetoothLowLevelDriver.h, Buzzer.cpp, Buzzer.h, BuzzerLowLevelDriver.cpp]
2026-07-10 Mirror twin link UX: heartbeat pulse, device summary, and connection recovery.
    Move the lanyard summary onto the left rail, flash side buttons on physical taps, pulse green on heartbeat, and surface a reset-device modal when the link goes quiet.
2026-07-10 Layer firmware stack and polish twin UI without killing alert audio.
    Extract BootSequence/Haptics and split BleTwin/Buzzer helpers so features stop reaching past lowlevel; fix both-hold clearing queued sirens; widen device logs and open them from a Logs button when enabled.
    [BluetoothLowLevelDriver.h]
2026-07-10 Fix desktop left rail scrolling in short viewports.
    Widen the column and keep rail widgets at natural height so overflow can reach telemetry and connection instead of clipping them under the stage.
2026-07-12 feat: PCB schematic complete
    [ADAFRUIT_SK6812_SIDE_4691.stp, CMT-7525-03-SMT-TR.stp, DRV2605LDGSR.stp, ILSS_PCB_2026_DEMO.kicad_pcb, ILSS_PCB_2026_DEMO.kicad_sch, IN-S63BT.stp, MAX17048G_T10.step, S2B-PH-SM4-TB.step]
2026-07-13 feat: schematic finalised, pcb routed
    [ILSS_PCB_2026_DEMO.kicad_pcb, ILSS_PCB_2026_DEMO.kicad_sch, bom.csv, designators.csv, positions.csv]
2026-07-23 Update PCB BOM exclusions and export manufacturing artifacts.
    Mark DNP/non-BOM parts on the schematic and add the exported BOM CSV plus STEP model.
    [ILSS_PCB_2026_DEMO.csv, ILSS_PCB_2026_DEMO.kicad_sch]
2026-07-23 chore: ignore nested .DS_Store and KiCad local prefs.
    Stop tracking macOS Finder metadata and *.kicad_prl so local editor state stays out of the repo.
2026-07-23 feat(firmware): bring up DisabilityIn PCB with crypto and twin hardening.
    Map XIAO pins for the demo board, add ATECC608B/I2C diagnostics and USB CLI tests, and harden BLE twin apply, conn params, and indications under alert load.
2026-07-23 feat(frontend): enrich device logs and stop twin echo loops.
    Parse BLE log lines into structured cards, fix ACK/Status mirroring that bounced idle state, and align the sim with DisabilityIn idle/display defaults.
2026-07-24 feat(frontend): add PostHog analytics for demo usage events.
    Track pairing, simulations, custom indicators, audio, and logs views on Vercel production only, via a self-contained facade aligned with PostHog's React SDK setup.
2026-07-24 feat(frontend): track alert resets and attach lanyard serial to events.
    Add Fire/Personal simulation reset events, and set lanyard_serial as a PostHog super-property (and on every custom capture) while a device is paired.
